RemoteLabSydneyUni/RedundantTrussRig/Documentations/Hardware/LoadCell_datasheet.PNG

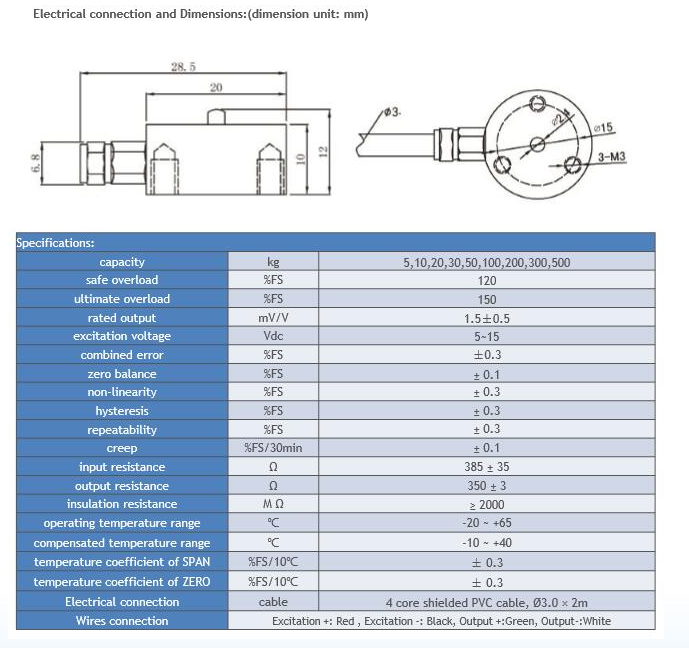
Documentations/Hardware/LoadCell_datasheet.PNG
