RemoteLabSydneyUni/RedundantTrussRig/Documentations/Hardware/AngleMotor_Datasheet.PNG

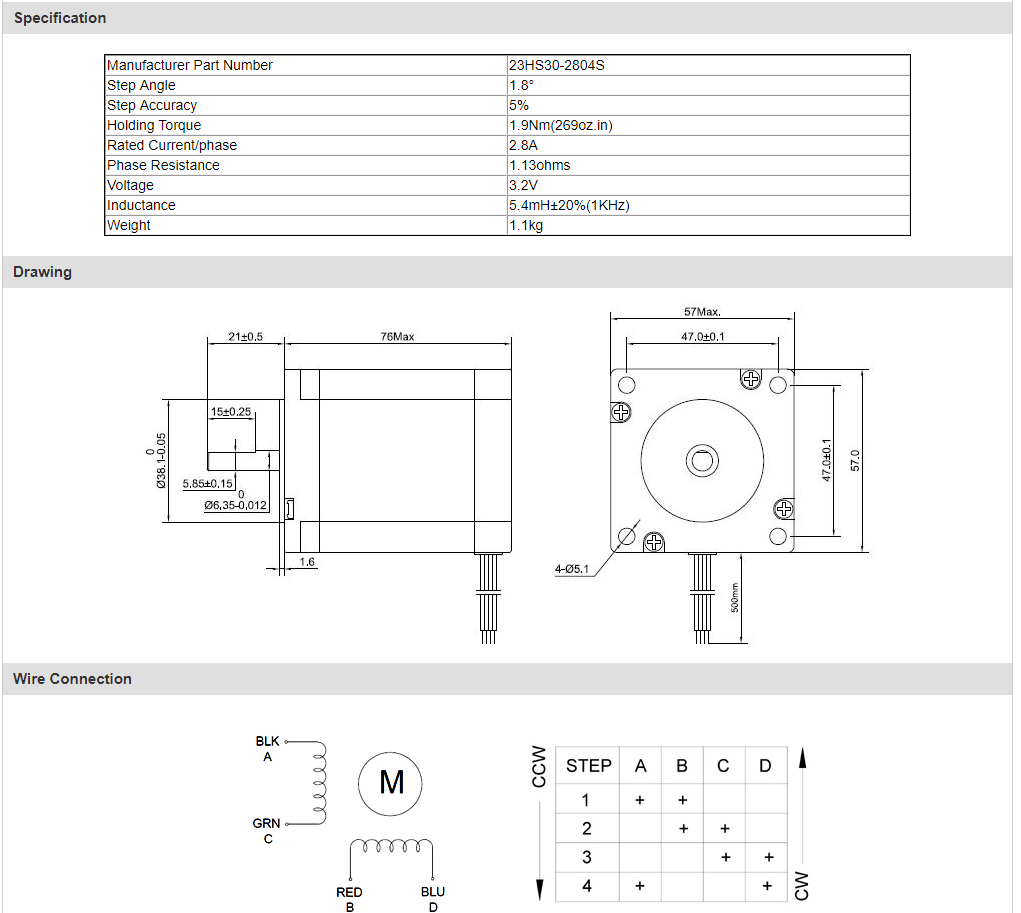
Documentations/Hardware/AngleMotor_Datasheet.PNG
