RemoteLabSydneyUni/RedundantTrussRig/Documentations/Hardware/Spring.PNG

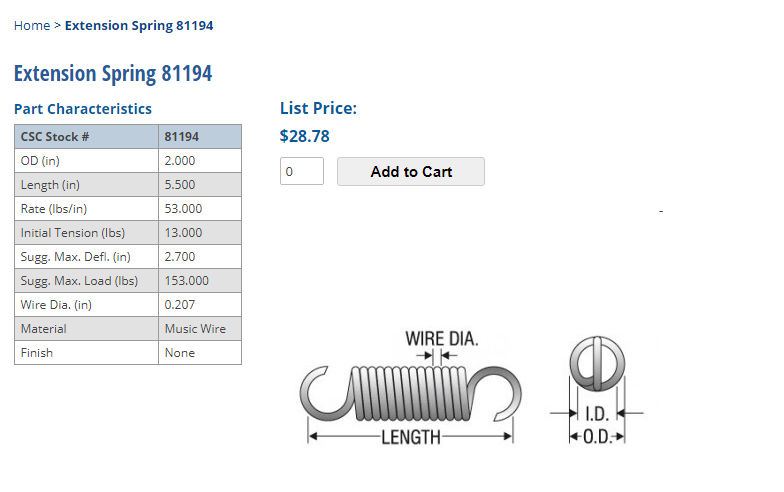
Documentations/Hardware/Spring.PNG
