RemoteLabSydneyUni/RedundantTrussRig/Documentations/Hardware/WinchDrum_datasheet.jpg

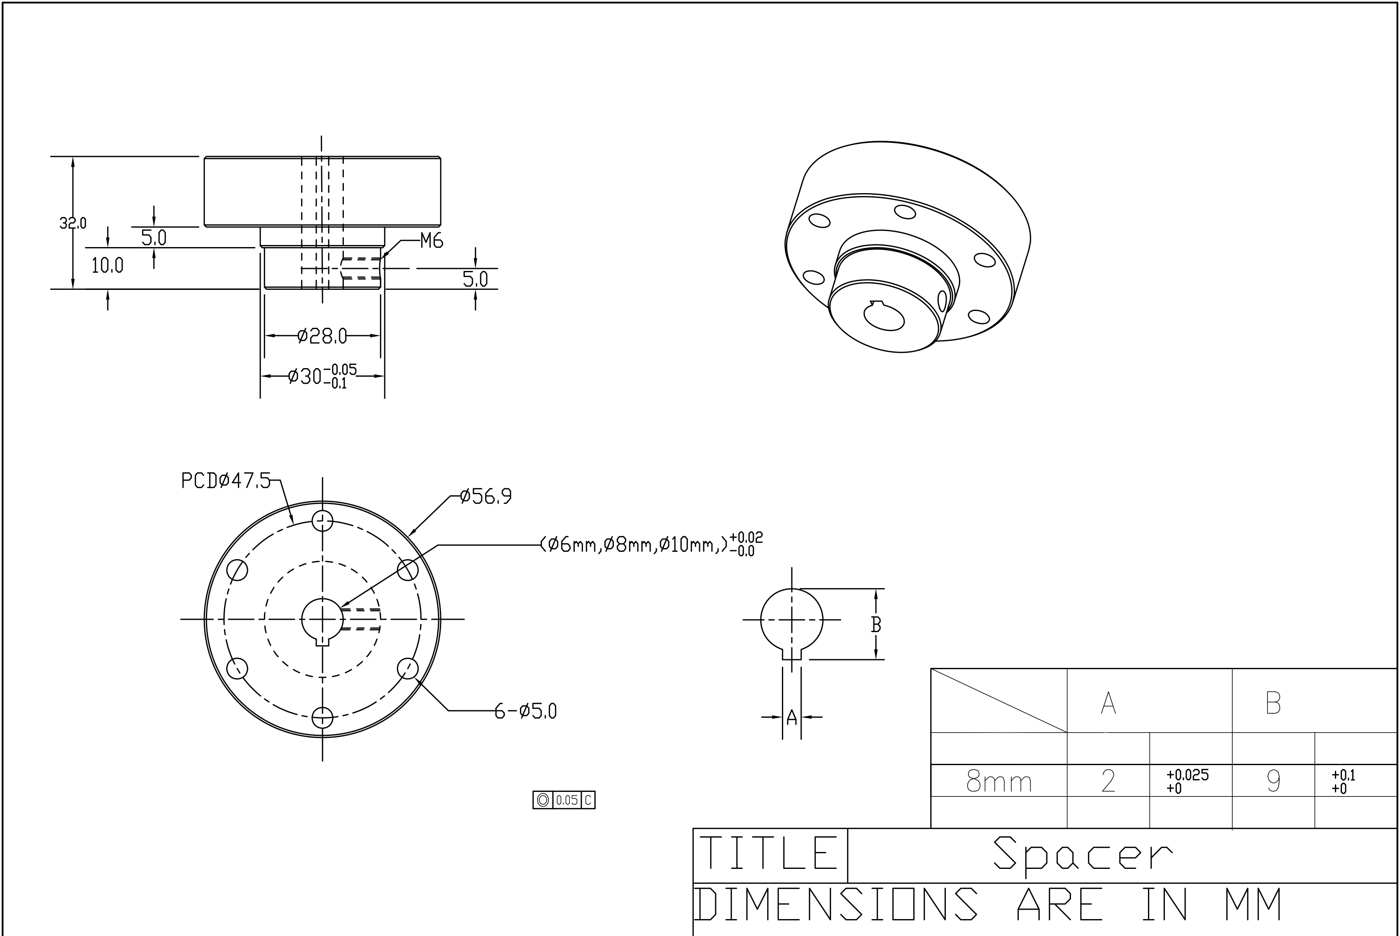
Documentations/Hardware/WinchDrum_datasheet.jpg
