RemoteLabSydneyUni/RedundantTrussRig/Documentations/Hardware/AngleControlUpgradingPlan.pdf

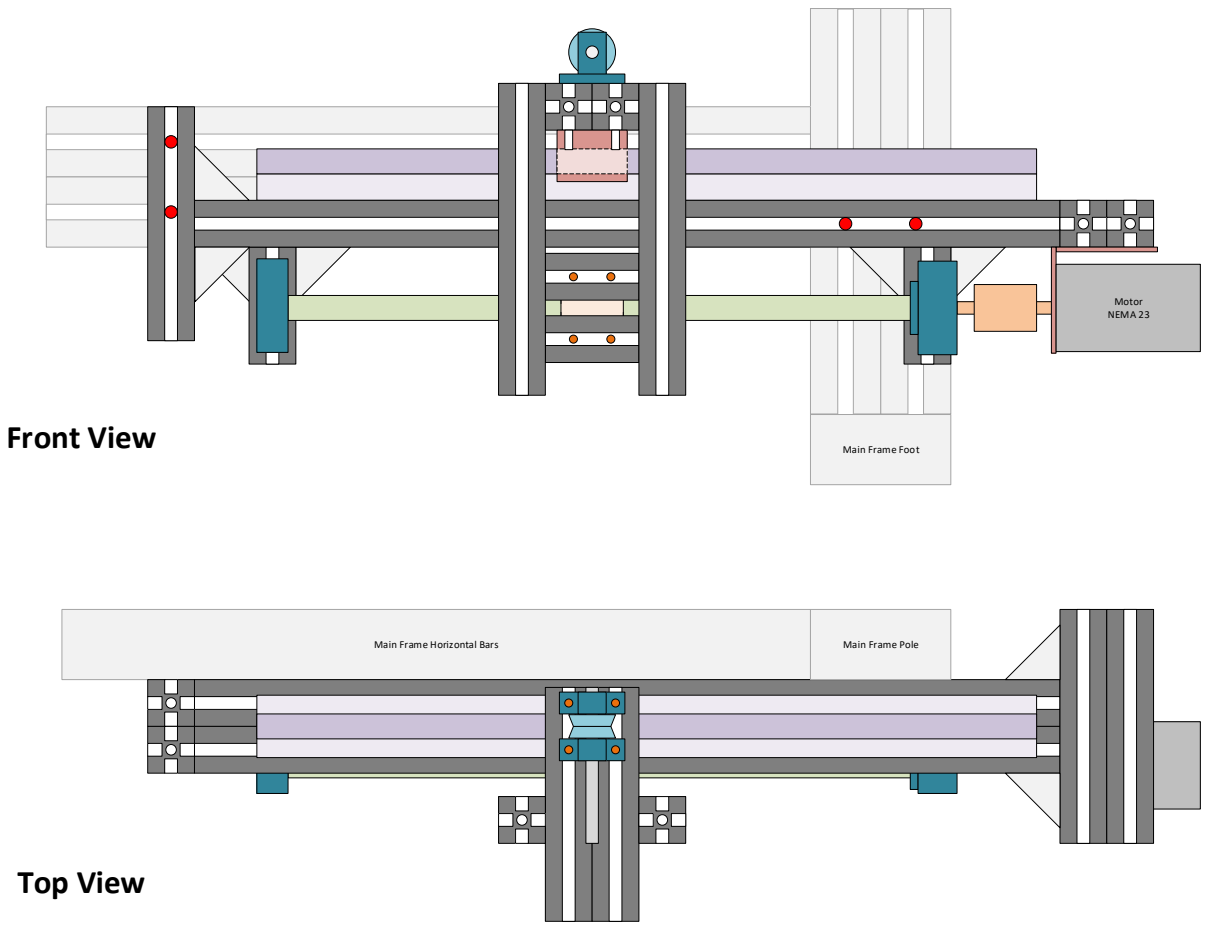
[picture p5: page 1]
Motor NEMA 23; Front View; Top View

Main Frame Foot

Main Frame Horizontal Bars

Main Frame Pole

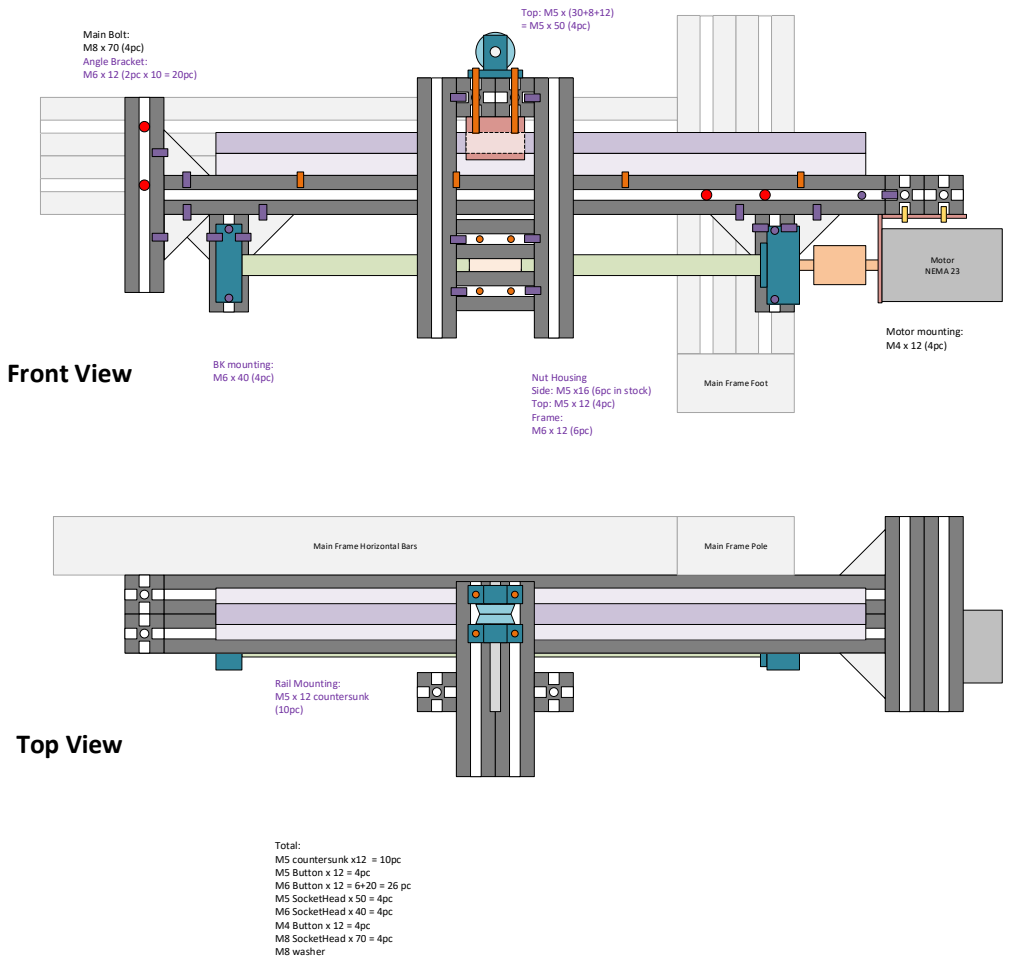
[picture p6: page 2]
Motor NEMA 23; Front View; Top View; Nut Housing Side: M5 x16 (6pc in stock) Top: M5 x 12 (4pc) Frame: M6 x 12 (6pc); Top: M5 x (30+8+12) = M5 x 50 (4pc); Main Bolt: M8 x 70 (4pc) Angle Bracket: M6 x 12 (2pc x 10 = 20pc); BK mounting: M6 x 40 (4pc); Motor mounting: M4 x 12 (4pc); Rail Mounting: M5 x 12 countersunk (10pc)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

Main Frame Foot

Main Frame Horizontal Bars

Main Frame Pole

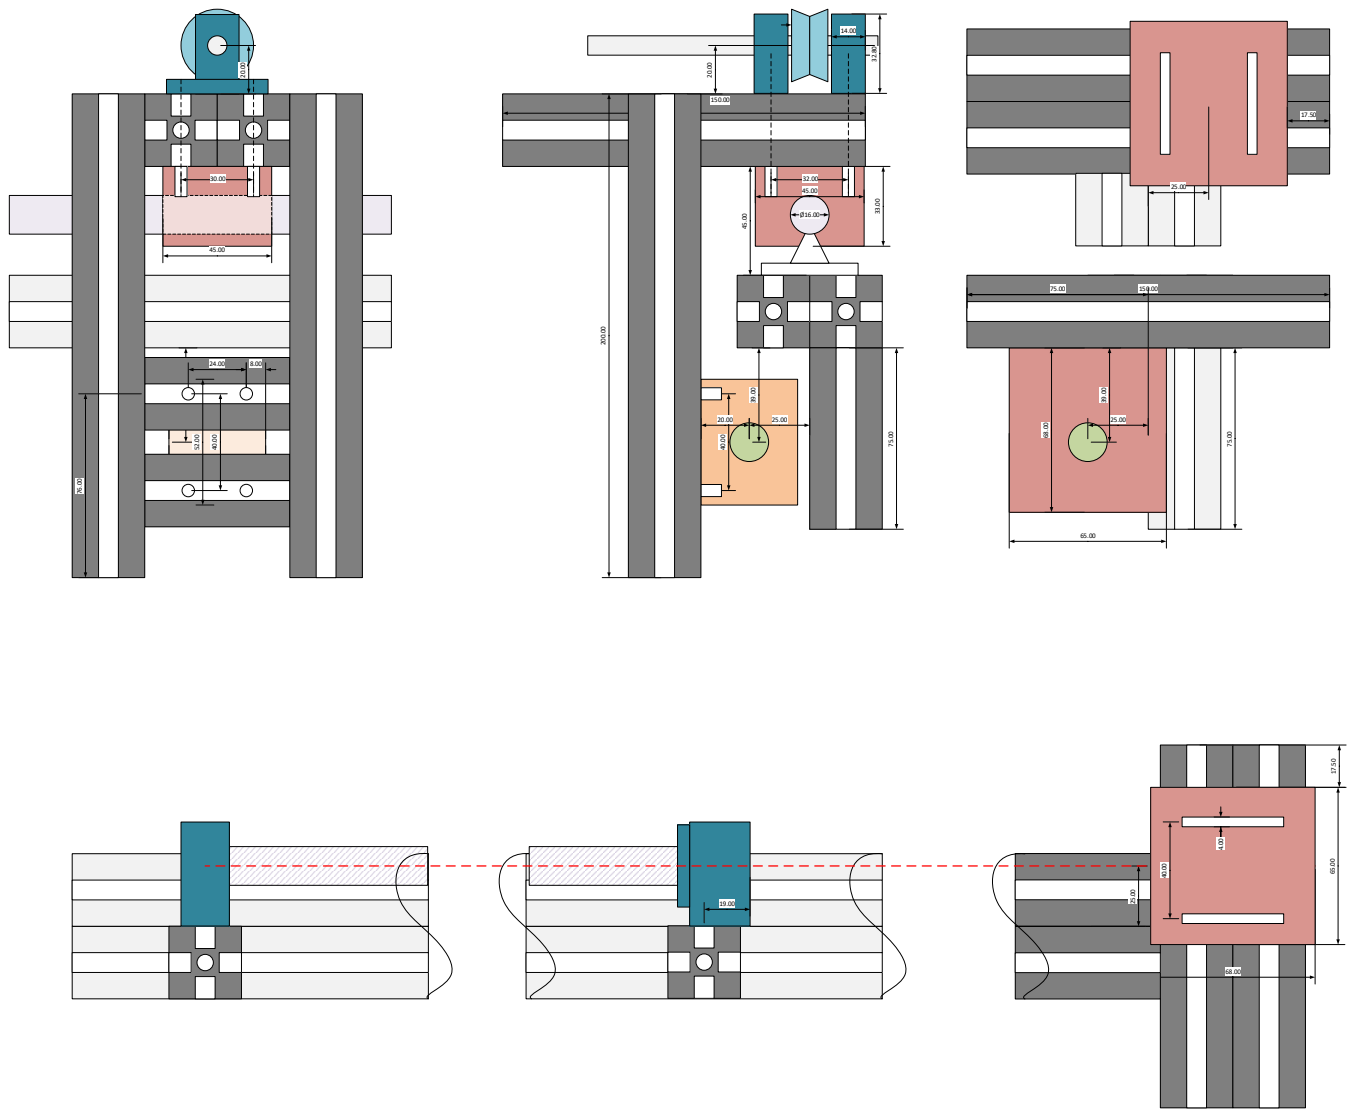
[picture p7: page 3]
