RemoteLabSydneyUni/RedundantTrussRig/Documentations/Hardware/New Mounting Plate for Winch.pdf

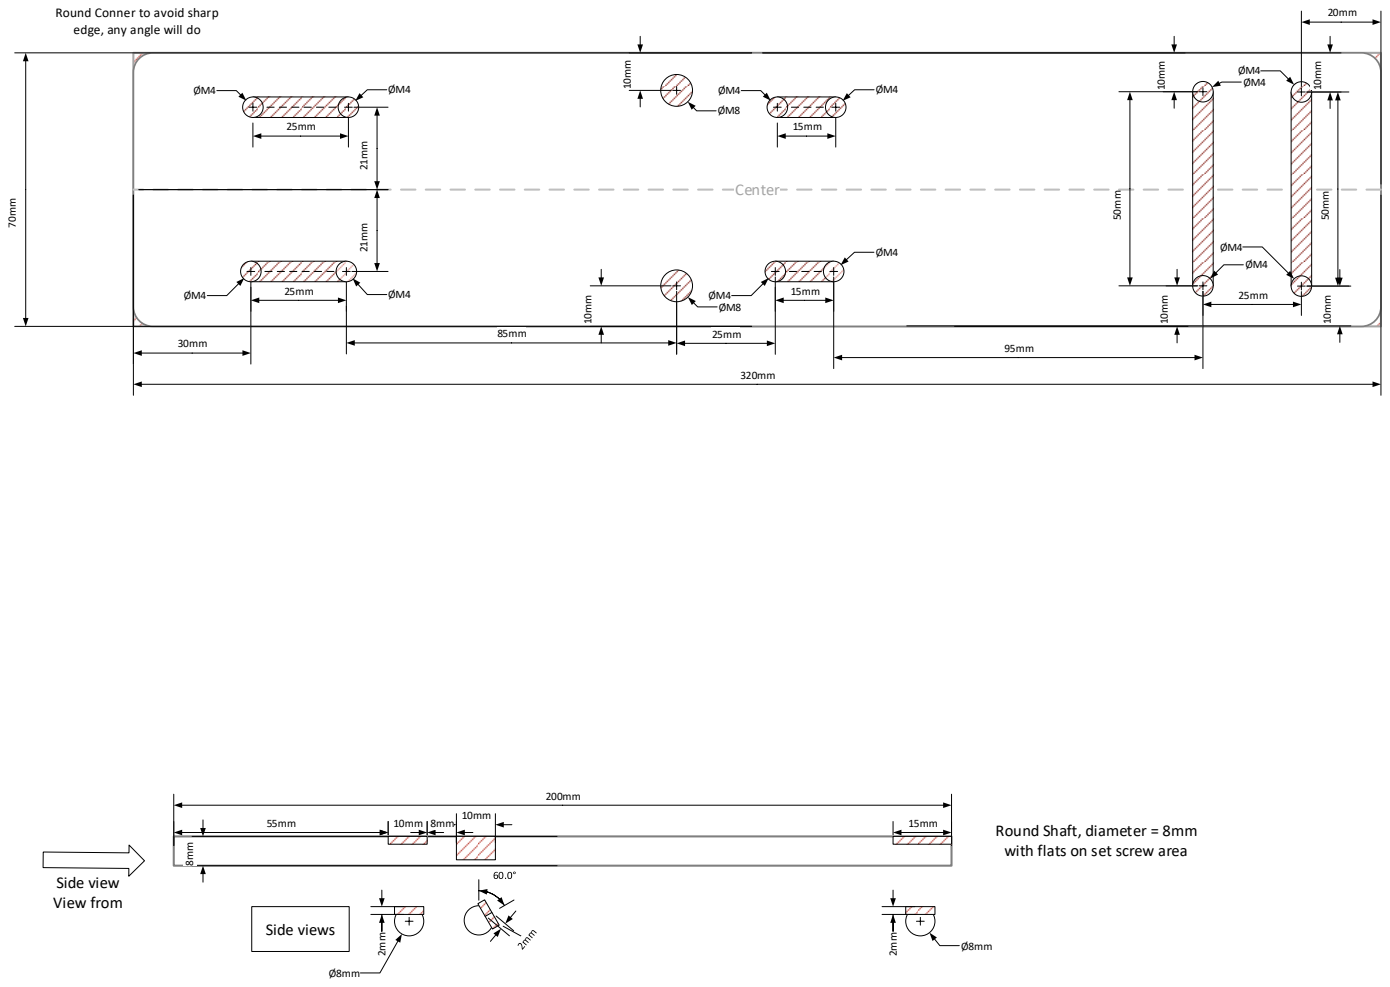
[picture p8: page 1]
Center; ØM4 ²¹mm; Side view View from; Side views

Round Conner to avoid sharp
edge, any angle will do

Round Shaft, diameter = 8mm
with flats on set screw area
