RemoteLabSydneyUni/RedundantTrussRig/Documentations/Circuit/Circuit.pdf

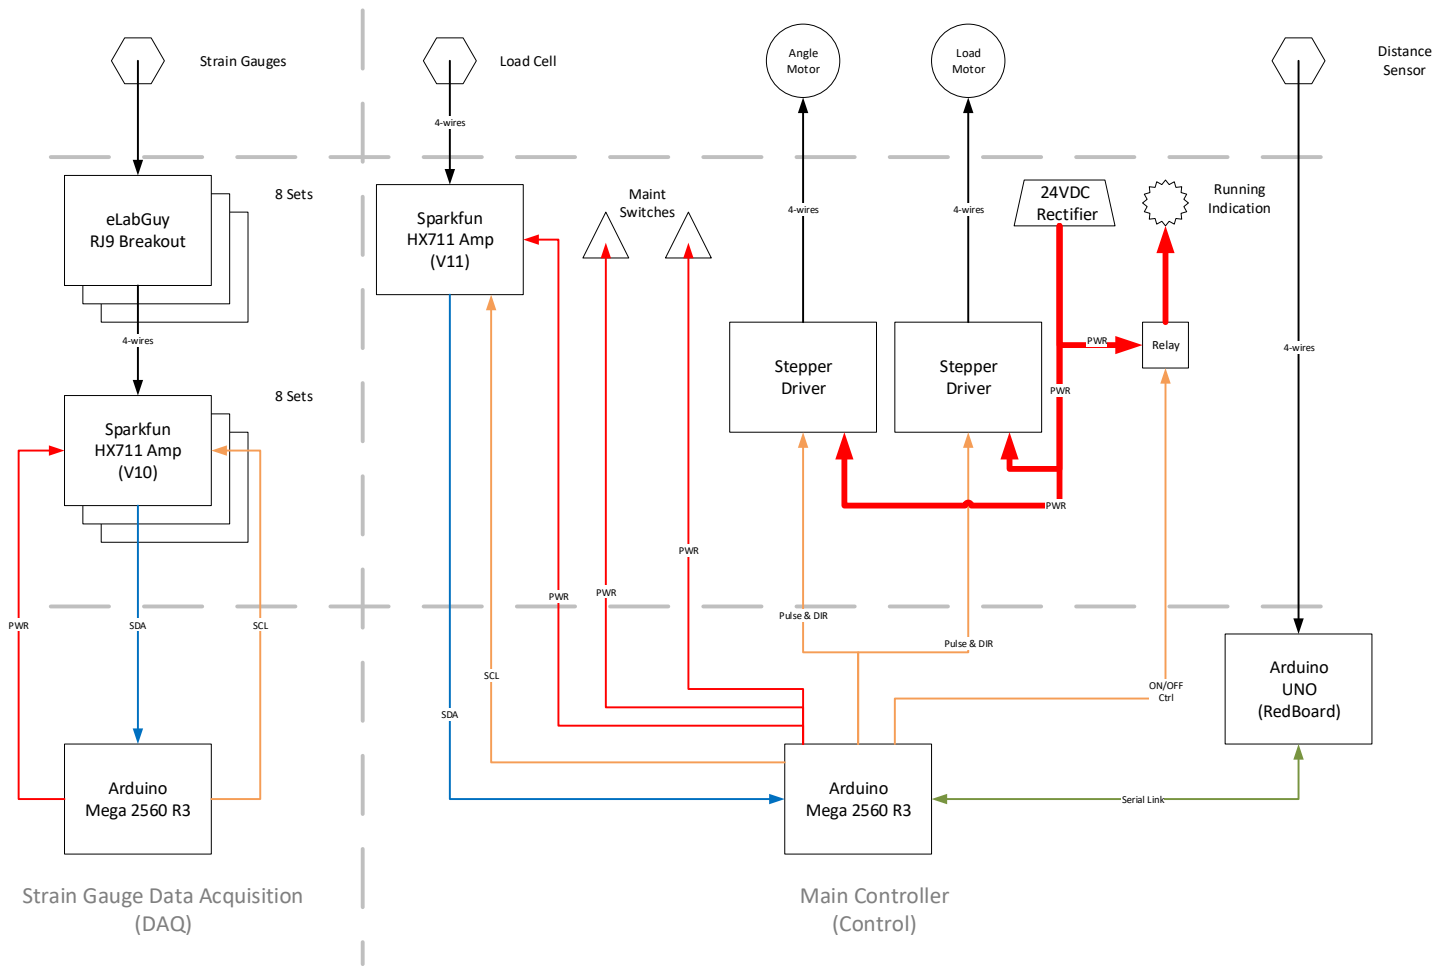
[picture p9: page 1]
Arduino Mega 2560 R3; eLabGuy RJ9 Breakout; Sparkfun HX711 Amp (V10); 8 Sets; Strain Gauges; 4-wires; PWR; SDA; SCL; (DAQ); Load Cell; Sparkfun HX711 Amp (V11); Main Controller (Control); Distance Sensor; Arduino UNO (RedBoard); Serial Link; Maint Switches; Stepper Driver; Pulse & DIR; 24VDC Rectifier; Angle Motor; Load Motor; Running Indication; Relay PWR

SCL

ON/OFF Ctrl

SDA

Strain Gauge Data Acquisition
