RemoteLabSydneyUni/RedundantTrussRig/Documentations/Control/Controls.pdf

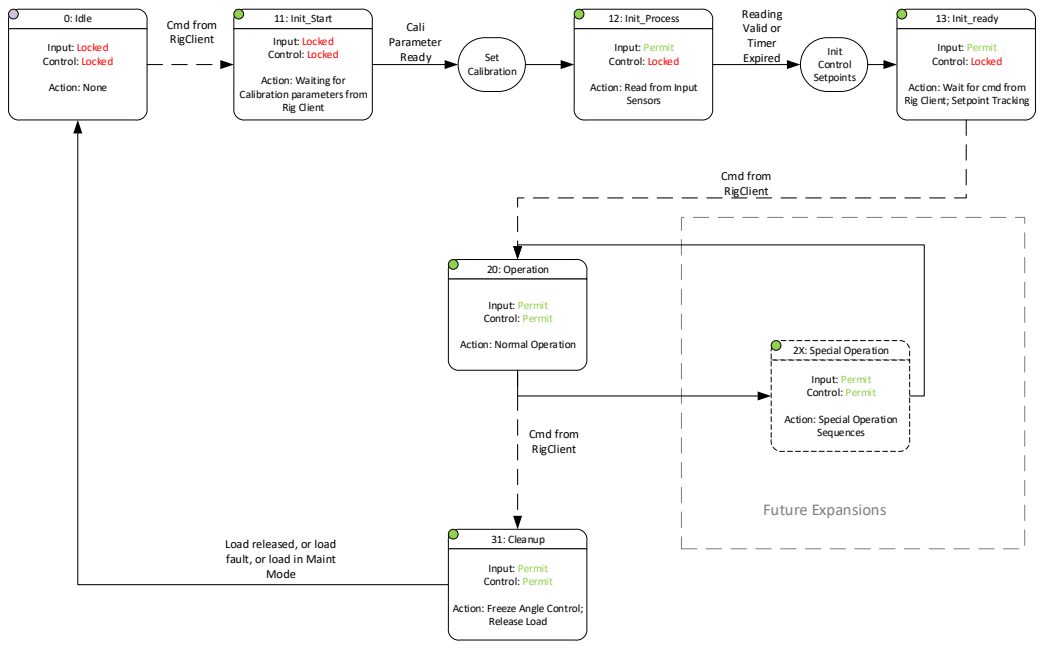
[picture p10: page 1]
0: Idle; Input: Locked Control: Locked; Action: None; 11: Init_Start; Rig Client; Cmd from RigClient; 12: Init_Process; Input: Permit Control: Locked; Sensors; Cali Parameter; Ready; Set; Calibration; 13: Init_ready; Reading Valid or Timer; Expired; Init; Control Setpoints; 20: Operation; Input: Permit Control: Permit; 31: Cleanup; Release Load; Mode; 2X: Special Operation; Future Expansions

Action: Waiting for
Calibration parameters from

Action: Read from Input

Action: Wait for cmd from
Rig Client; Setpoint Tracking

Action: Normal Operation

Action: Special Operation
Sequences

Load released, or load
fault, or load in Maint

Action: Freeze Angle Control;

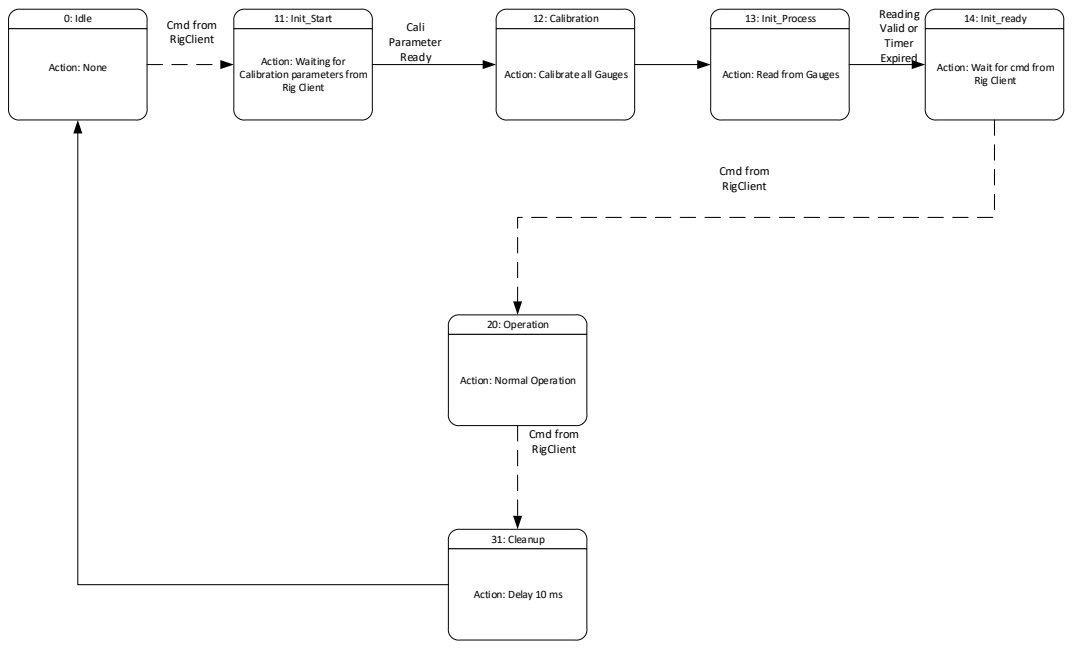
[picture p11: page 2]
0: Idle; Action: None; 11: Init_Start; Rig Client; Cmd from RigClient; 13: Init_Process; Cali Parameter Ready; 14: Init_ready; Reading Valid or Timer Expired; 20: Operation; 31: Cleanup; 12: Calibration

Action: Waiting for
Calibration parameters from

Action: Wait for cmd from

Action: Calibrate all Gauges

Action: Read from Gauges

Action: Normal Operation

Action: Delay 10 ms

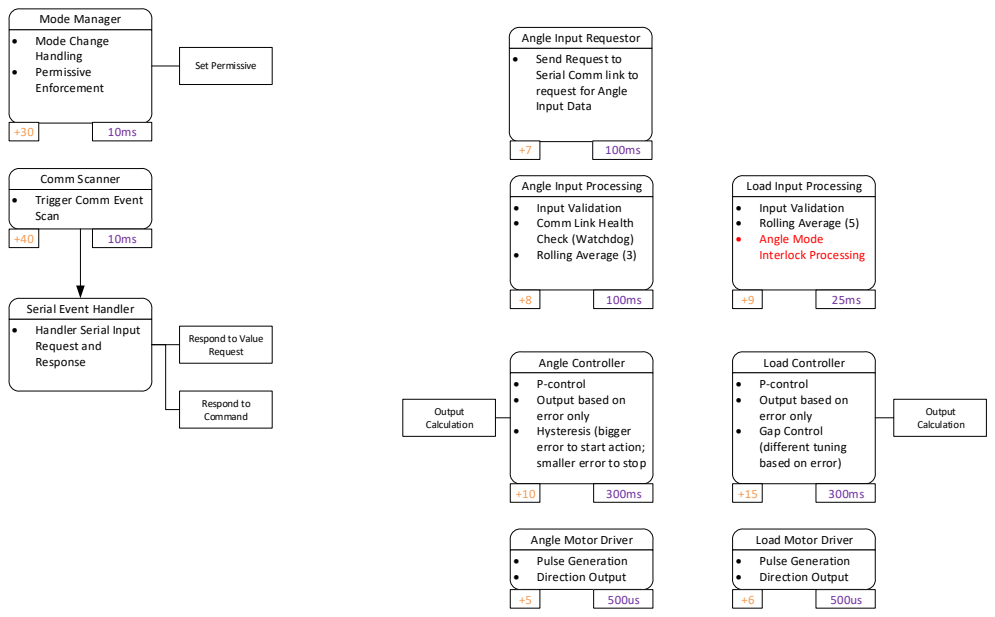
[picture p12: page 3]
Mode Manager; • Mode Change Handling • Permissive Enforcement; Output Calculation; Set Permissive; Respond to Command

Angle Input Requestor
• Send Request to
Serial Comm link to
request for Angle
Input Data

Comm Scanner
• Trigger Comm Event
Scan

Angle Input Processing
• Input Validation
• Comm Link Health
Check (Watchdog)
• Rolling Average (3)

Load Input Processing
• Rolling Average (5)
• Angle Mode
Interlock Processing

Serial Event Handler
• Handler Serial Input
Request and
Response

Respond to Value
Request

Angle Controller
• P-control
• Output based on
error only
• Hysteresis (bigger
error to start action;
smaller error to stop

Load Controller
• Gap Control
(different tuning
based on error)

Angle Motor Driver
• Pulse Generation
• Direction Output

Load Motor Driver
