RemoteLabSydneyUni/RedundantTrussRig/Documentations/Hardware/Winch.pdf

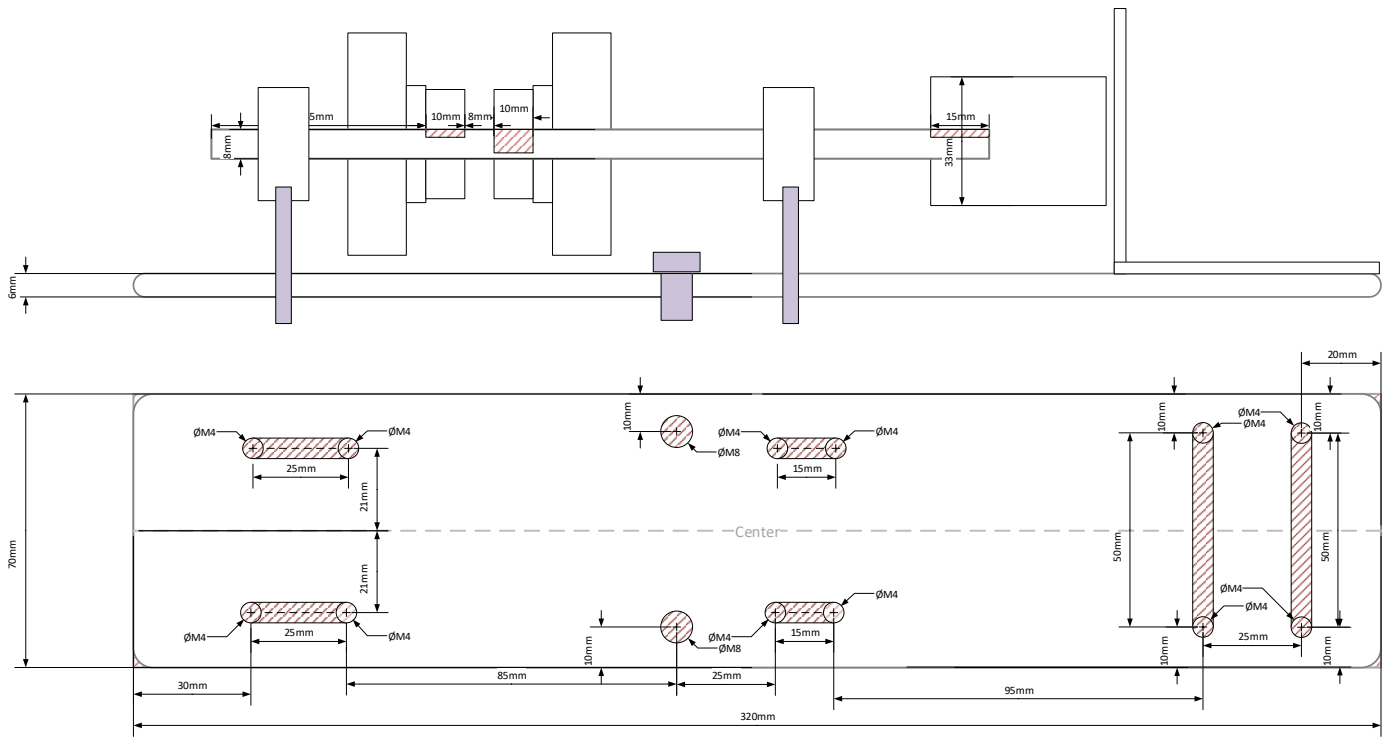
[picture p13: page 1]
Center
