RemoteLabSydneyUni/RedundantTrussRig/Documentations/Circuit/SparkFun_HX711_Load_Cell_v10.pdf

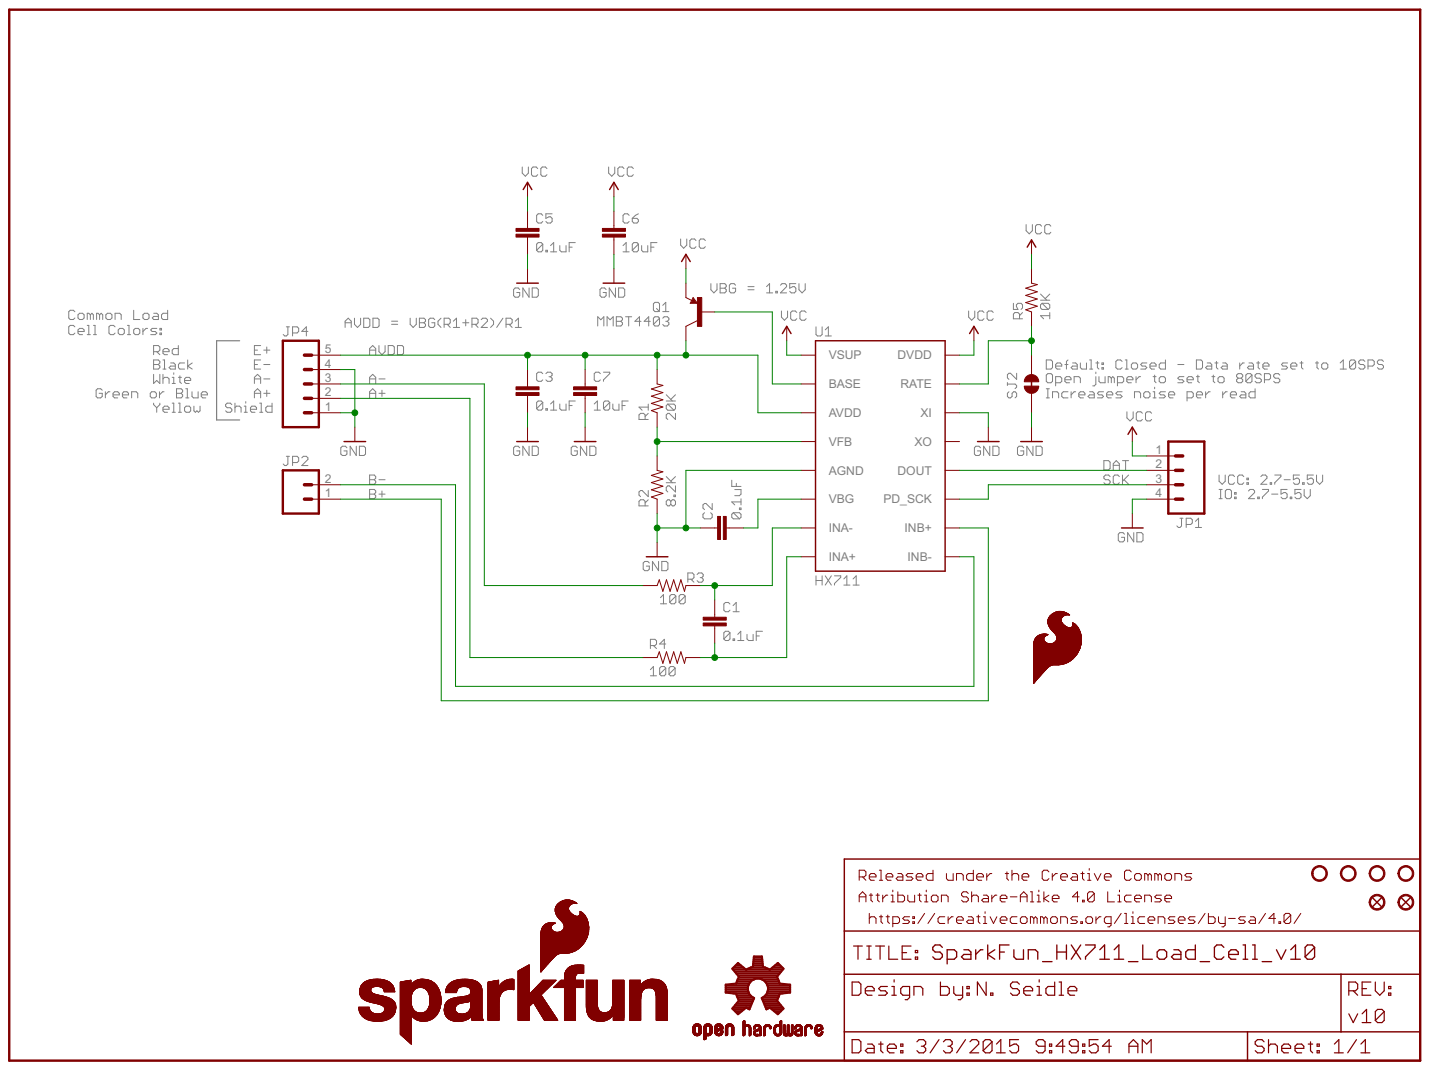
[picture p14: page 1]
