RemoteLabSydneyUni/RedundantTrussRig/(commit log)

2018-03-29 Commit 29/03/2018: pre-production rollout
    [Ctrl.cfg, Daq.cfg, Gauges.cfg, Reference.cfg]
2018-04-05 Add max&min load target setting retrieving from rig config file Add enable/disable switch for auto-zeroing at start (from config file)
2018-04-18 Calibration of Load Sensor; Add Documentations
    [Gauges.cfg]
